peplinskijohn/WLED_KBIS_26/docs/images/1000009515.jpg

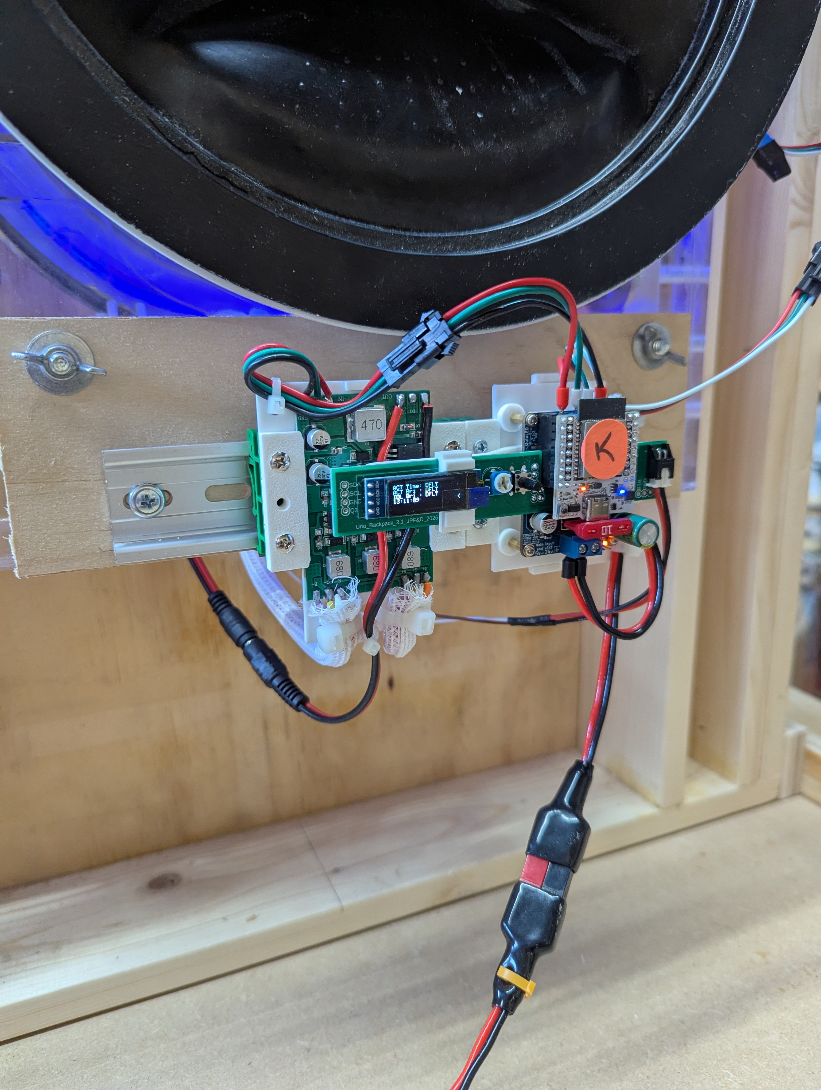
docs/images/1000009515.jpg
