peplinskijohn/WLED_KBIS_26/usermods/KBIS26/assets/Dig_Uno_Image.png

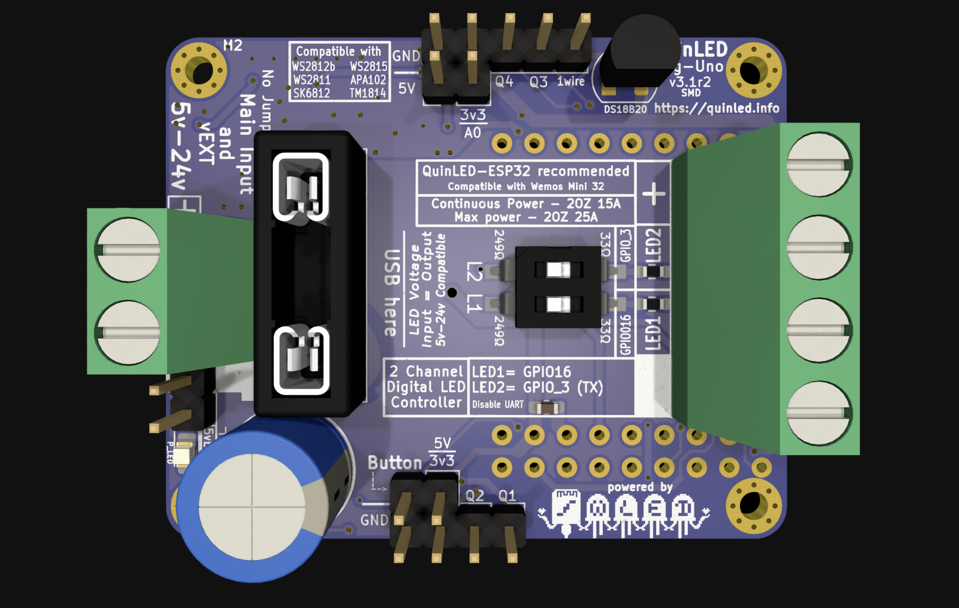
usermods/KBIS26/assets/Dig_Uno_Image.png
