peplinskijohn/WLED_KBIS_26/docs/images/README.md

images taken to document working hardware and assembly.
