peplinskijohn/WLED_KBIS_26/docs/images/1000009498.jpg

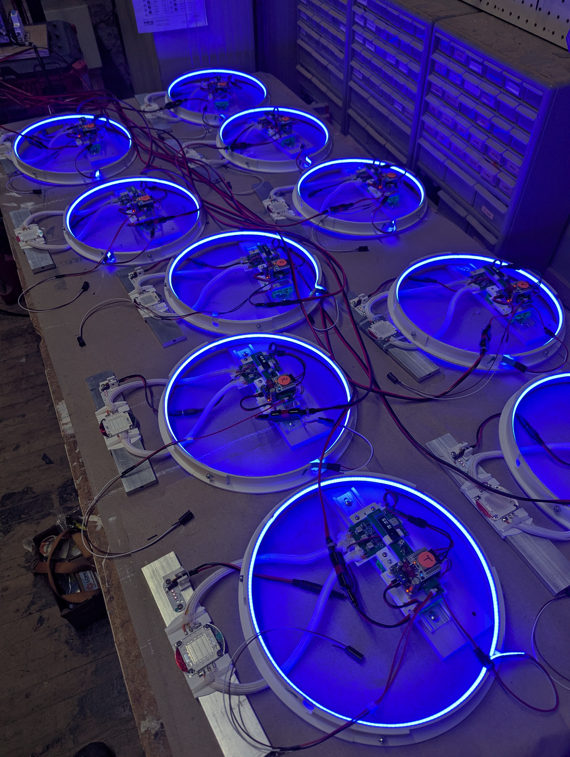
docs/images/1000009498.jpg
