peplinskijohn/WLED_KBIS_26/docs/images/1000009508.jpg

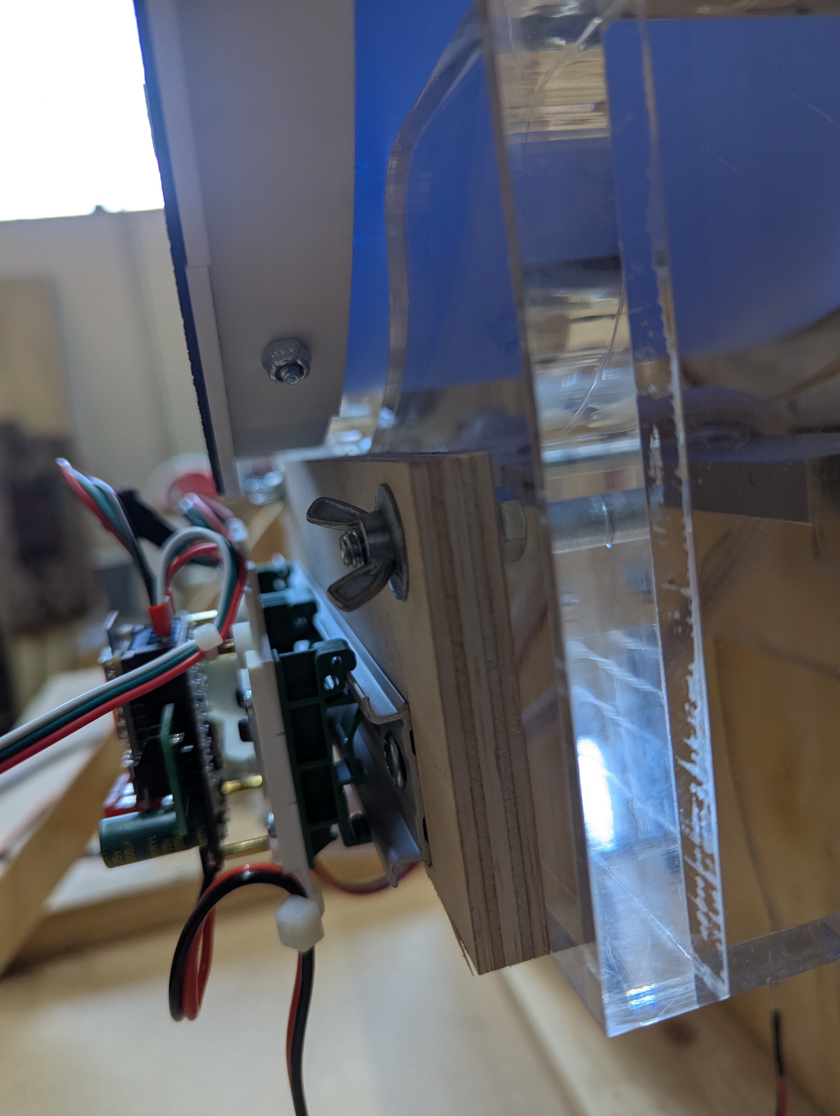
docs/images/1000009508.jpg
