peplinskijohn/WLED_KBIS_26/docs/images/1000009510.jpg

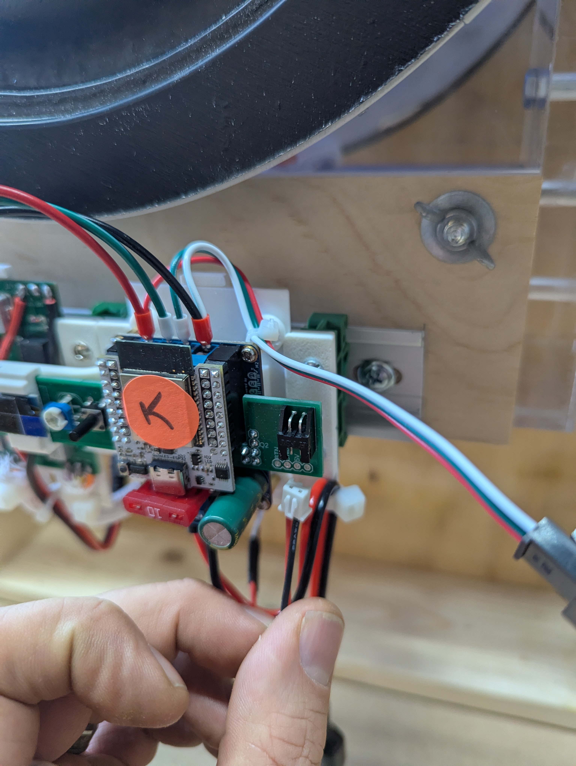
docs/images/1000009510.jpg
