peplinskijohn/WLED_KBIS_26/docs/images/1000009511.jpg

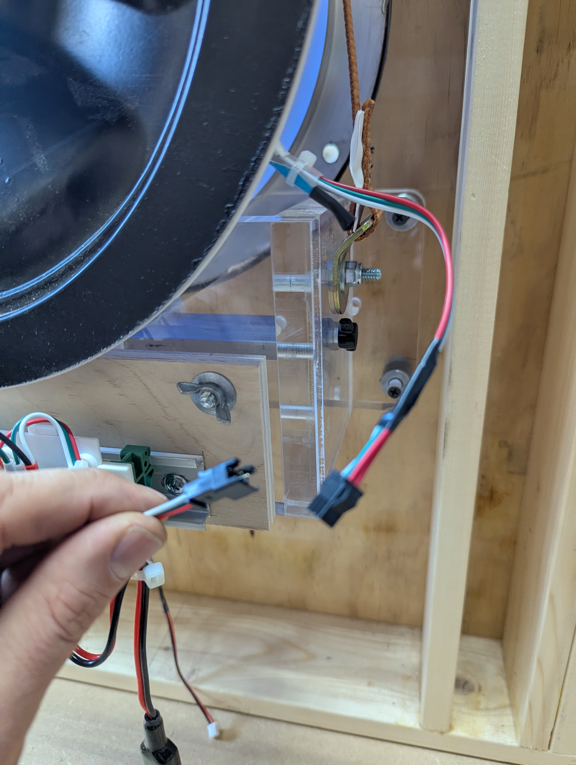
docs/images/1000009511.jpg
