peplinskijohn/WLED_KBIS_26/docs/images/1000009512.jpg

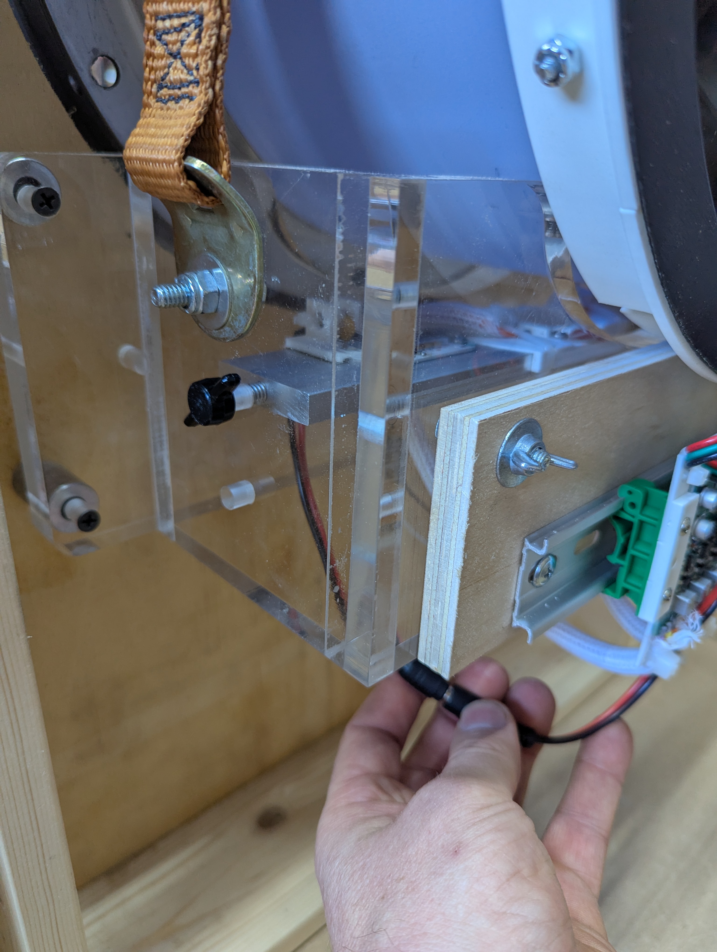
docs/images/1000009512.jpg
