peplinskijohn/WLED_KBIS_26/docs/images/1000009516.jpg

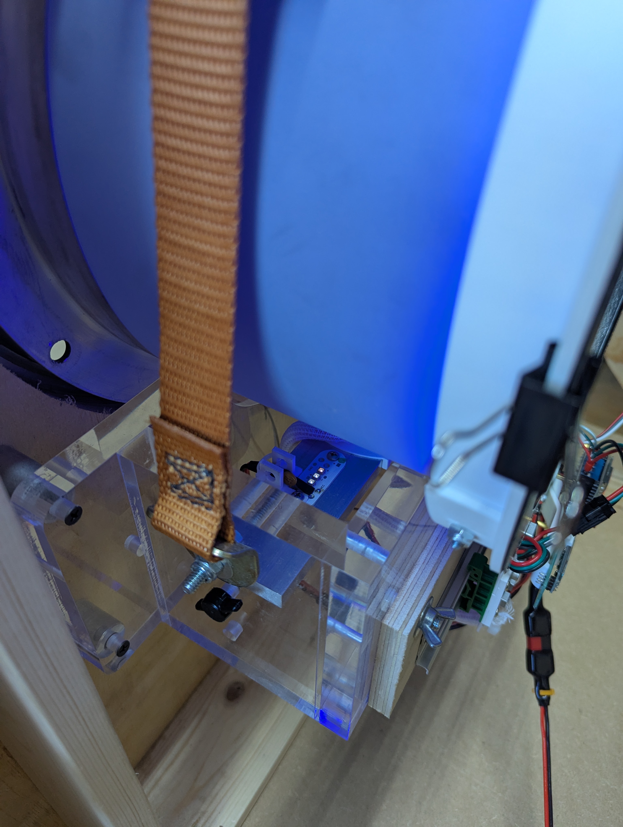
docs/images/1000009516.jpg
