peplinskijohn/WLED_KBIS_26/usermods/KBIS26/assets/BackpackSchmatic.png

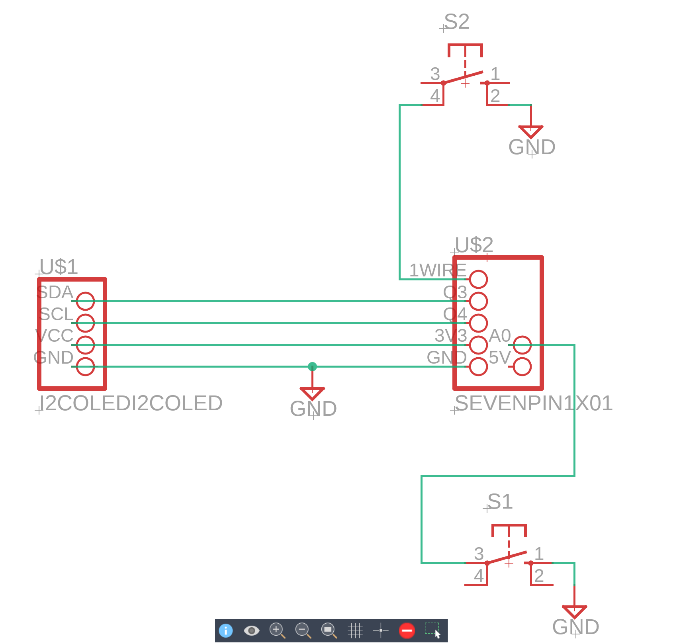
usermods/KBIS26/assets/BackpackSchmatic.png
