peplinskijohn/WLED_KBIS_26/usermods/KBIS26/assets/Dig_ESP_2.png

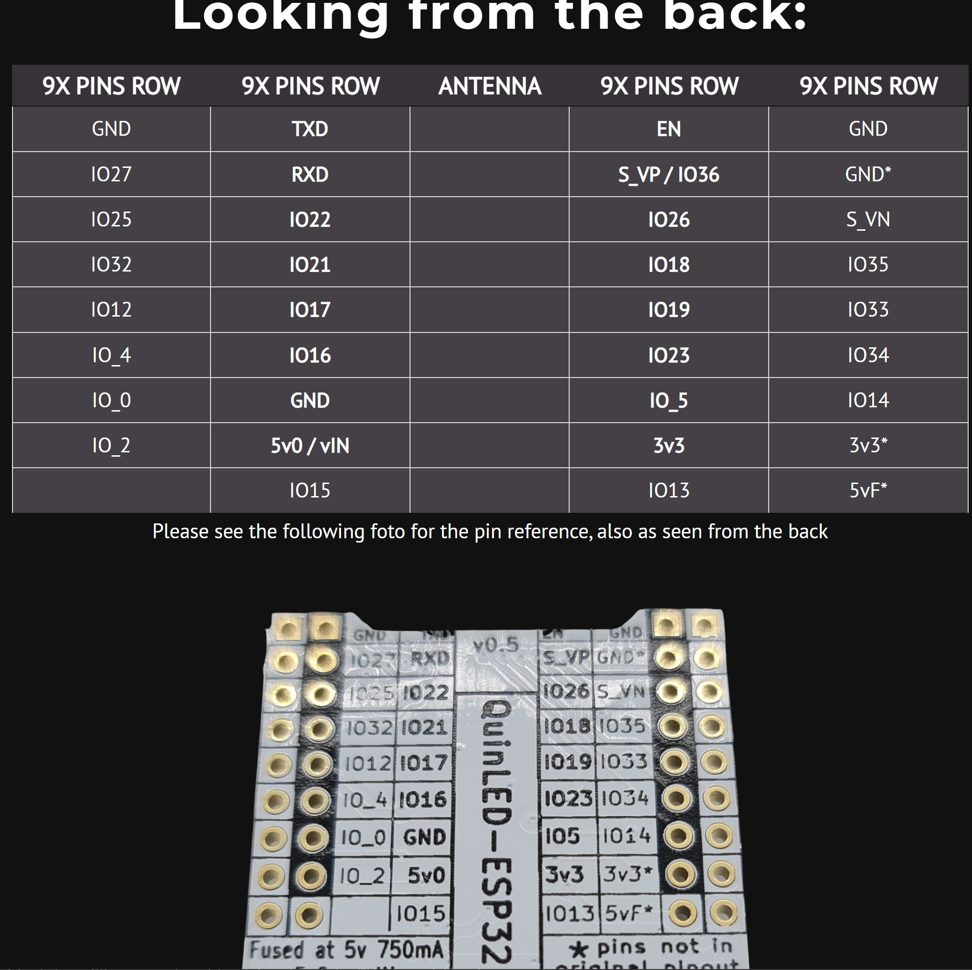
usermods/KBIS26/assets/Dig_ESP_2.png
