peplinskijohn/WLED_KBIS_26/docs/HardwareBOM.md

High Power Led: WS2811 RGB high Power Module DC12-24V 30W RGB Addressable Pixel LED floodlight IP20 (2PCS-WS2811-30W-RGB)
https://www.amazon.com/dp/B0CYXVDVMT?ref=ppx_yo2ov_dt_b_fed_asin_title&th=1

Led Strip:  BTF-LIGHTING FCOB WS2811 IC RGB COB LED Strip DC24V 720LED/m 3.2FT
https://www.amazon.com/dp/B0BTHRV1R6?ref=ppx_yo2ov_dt_b_fed_asin_title&th=1

UVC leds: UV-C Disinfection LED Light Bar Strip
https://tinkersphere.com/standard-leds/3596-uv-c-disinfection-3-led-light-bar-strip.html
150 ohm Resistor 1W

Hardware for Electronics Mounting: 10 Sets C45 PCB DIN Rail Mounting Adapter 35mm 15mm Circuit Board Mounting Bracket Holder Carrier Clip
https://www.amazon.com/dp/B09KZHY8G4?ref=ppx_yo2ov_dt_b_fed_asin_title

400Pcs M2 Motherboard Standoffs&Screws&Nuts Kit
https://www.amazon.com/dp/B0BP6MT7RP?ref=ppx_yo2ov_dt_b_fed_asin_title&th=1

PSU: SDR-480P-24
https://www.mouser.com/ProductDetail/MEAN-WELL/SDR-480P-24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

PCB Parts: 5 Pcs 0.91 Inch I2C OLED Display Module IIC OLED Screen DC 3.3V~5V
https://www.amazon.com/dp/B09MZ8DW4R?ref=ppx_yo2ov_dt_b_fed_asin_title&th=1

228PCS 10 Values 6x6mm & 7x7mm Tactile Push Button Switch
https://www.amazon.com/dp/B0FNJVKZDQ?ref=ppx_yo2ov_dt_b_fed_asin_title&th=1

100 Ohm- 2M Ohm Variable Resistor
https://www.amazon.com/dp/B07WHJMVR4?ref=ppx_yo2ov_dt_b_fed_asin_title

S2B-XH-A-BK(LF)(SN)
https://www.mouser.com/ProductDetail/JST-Commercial/S2B-XH-A-BKLFSN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

Magnetic Reed Switch RC-33 NC/NO Recessed
https://www.amazon.com/Magnetic-RC-33-NC-NO-Recessed/dp/B0BG2V1S73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

XH 2.54mm Connector Kit
https://www.amazon.com/dp/B08G18PWQ6?ref=ppx_yo2ov_dt_b_fed_asin_title&th=1
