peplinskijohn/WLED_KBIS_26/docs/3d_print_files/KBIS26_Ring_1.3mf

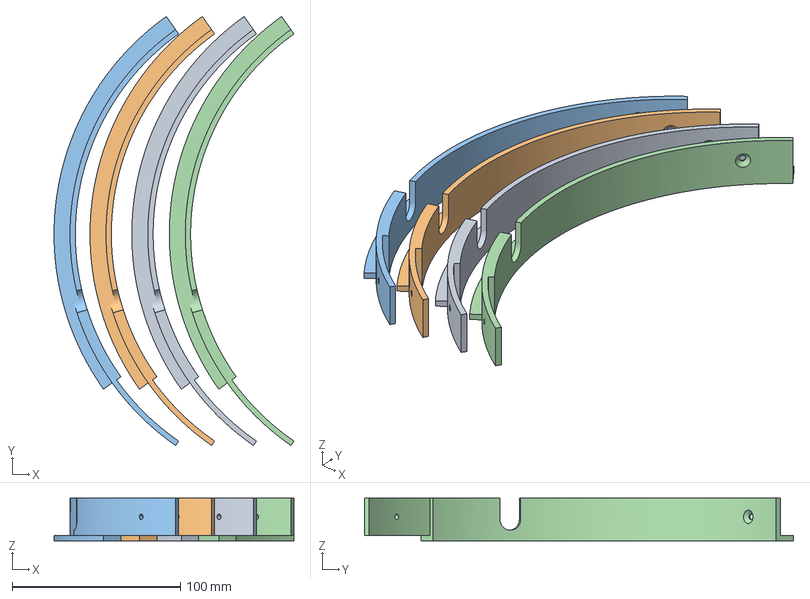
[picture p12: CAD file, 2026-02-28]
docs/3d_print_files/KBIS26_Ring_1.3mf
142.6 x 254.8 x 25.4 mm
KBIS26_Configuration 1_Body1.stl x 4
