peplinskijohn/WLED_KBIS_26/docs/3d_print_files/UVC_Clips_1.3mf

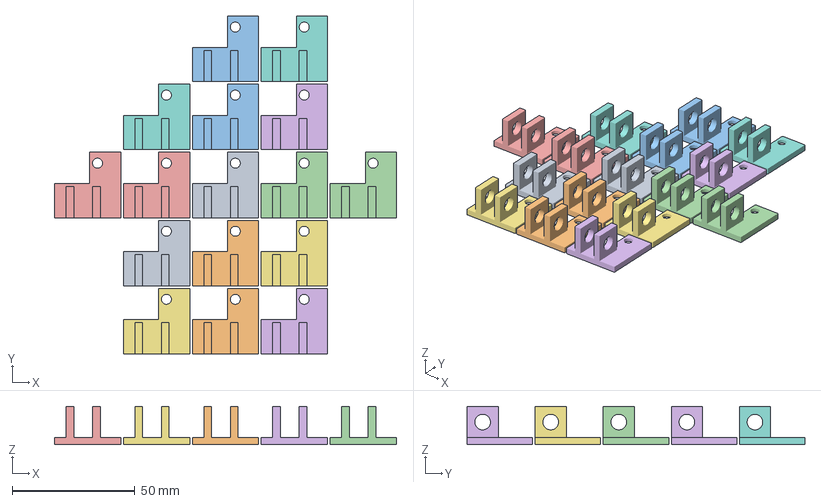
[picture p13: CAD file, 2026-02-28]
docs/3d_print_files/UVC_Clips_1.3mf
139.1 x 137.5 x 15.5 mm
KBIS26_Configuration 1_Body2.stl x 16
