peplinskijohn/WLED_KBIS_26/docs/3d_print_files/Pinch_1.3mf

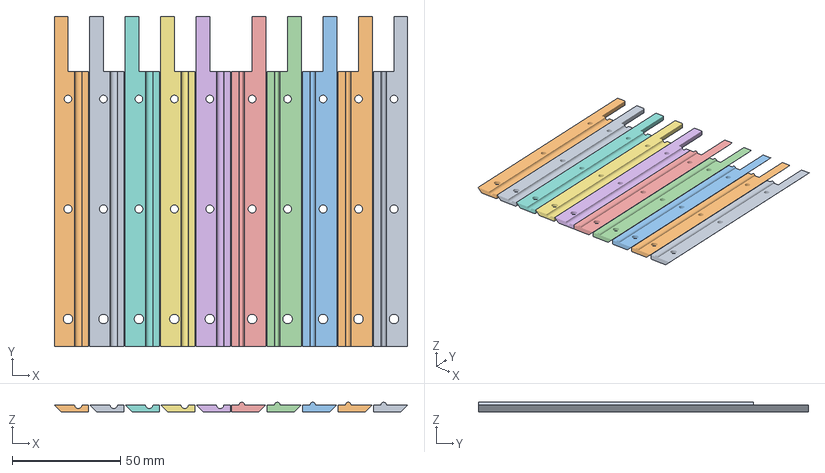
[picture p14: CAD file, 2026-02-28]
docs/3d_print_files/Pinch_1.3mf
163.2 x 152.4 x 4.44 mm
KBIS26_Configuration 1_Pinch.stl_1 x 5
KBIS26_Configuration 1_Pinch.stl_2 x 5
