peplinskijohn/WLED_KBIS_26/docs/3d_print_files/30W_Mount_1.3mf

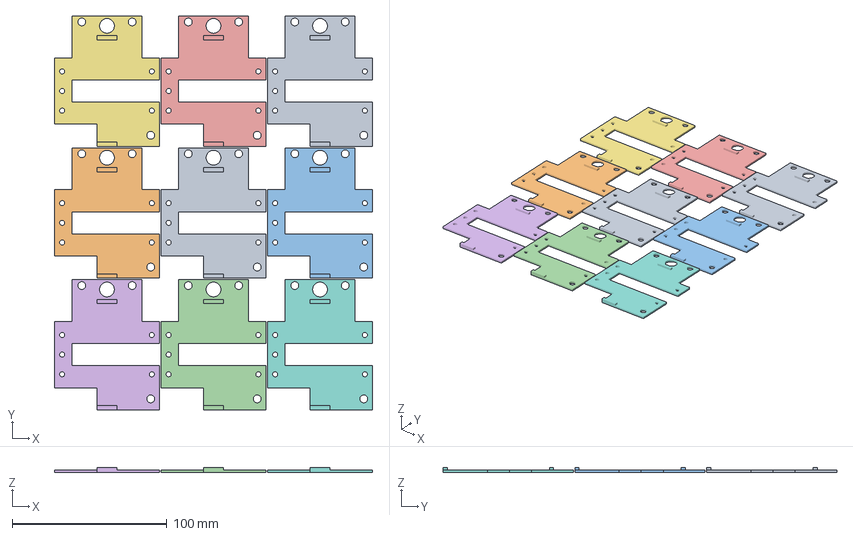
[picture p15: CAD file, 2026-02-28]
docs/3d_print_files/30W_Mount_1.3mf
205.6 x 254.6 x 3.18 mm
KBIS26_Configuration 1_Body1.stl x 9
