peplinskijohn/WLED_KBIS_26/docs/3d_print_files/Houses_1.3mf

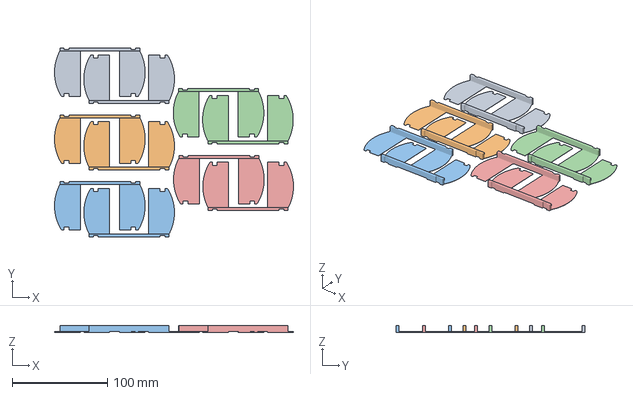
[picture p16: CAD file, 2026-02-28]
docs/3d_print_files/Houses_1.3mf
250.5 x 197.8 x 7.35 mm
Assembly x 5
