peplinskijohn/WLED_KBIS_26/docs/3d_print_files/KBIS26_Mounts_1.3mf

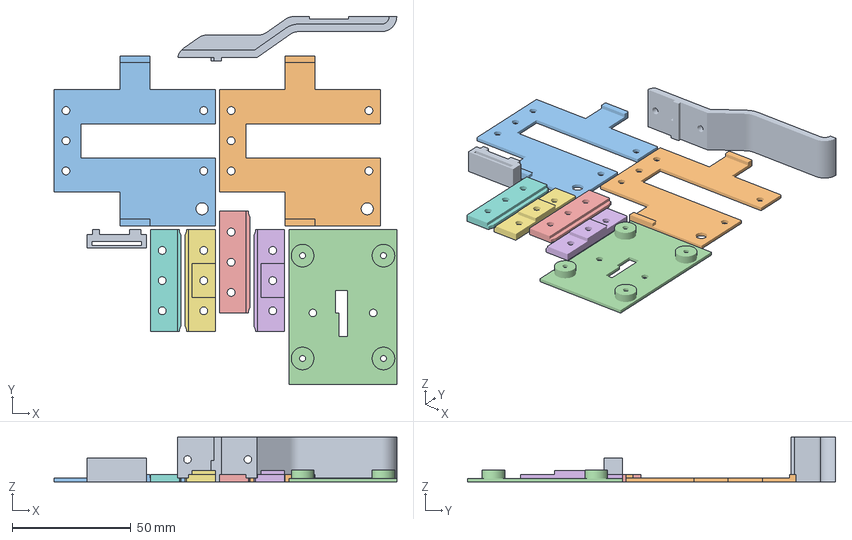
[picture p17: CAD file, 2026-02-28]
docs/3d_print_files/KBIS26_Mounts_1.3mf
144.1 x 154.8 x 18.9 mm
KBIS26_Configuration 1_Electronics.stl_8
KBIS26_Configuration 1_Electronics.stl_2 x 2
KBIS26_Configuration 1_Electronics.stl_5
KBIS26_Configuration 1_Electronics.stl_3 x 2
KBIS26_Configuration 1_Electronics.stl_4 x 2
KBIS26_Configuration 1_Electronics.stl_7
