peplinskijohn/WLED_KBIS_26/docs/3d_print_files/README.md

stls of pla parts used to hold electrical components.
Mounts for Dig Uno use brass standoffs: m2 x 10mm
