peplinskijohn/WLED_KBIS_26/usermods/KBIS26/assets/Dig-Uno_PinOut_Guide.png

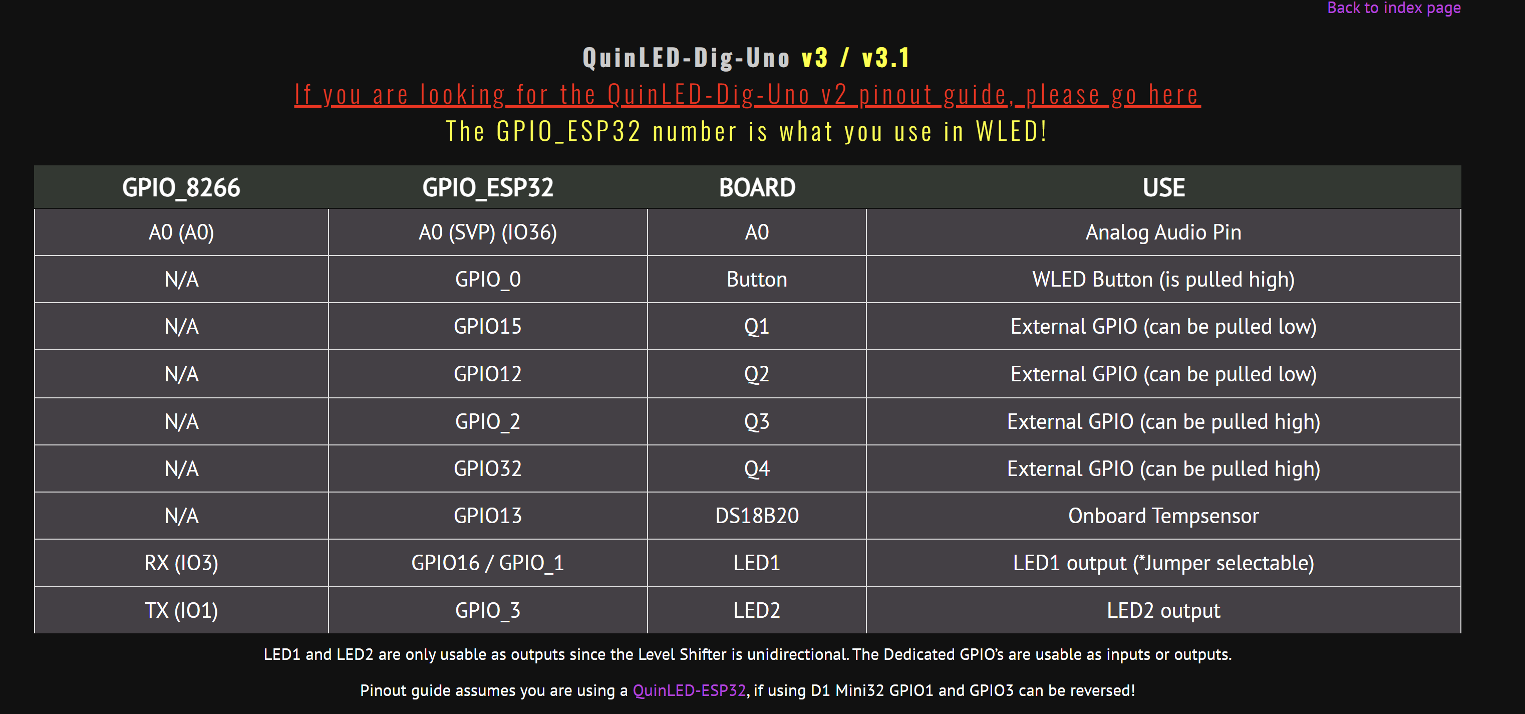
usermods/KBIS26/assets/Dig-Uno_PinOut_Guide.png
