peplinskijohn/WLED_KBIS_26/docs/3d_print_files/Electronics_Panel_1.pdf

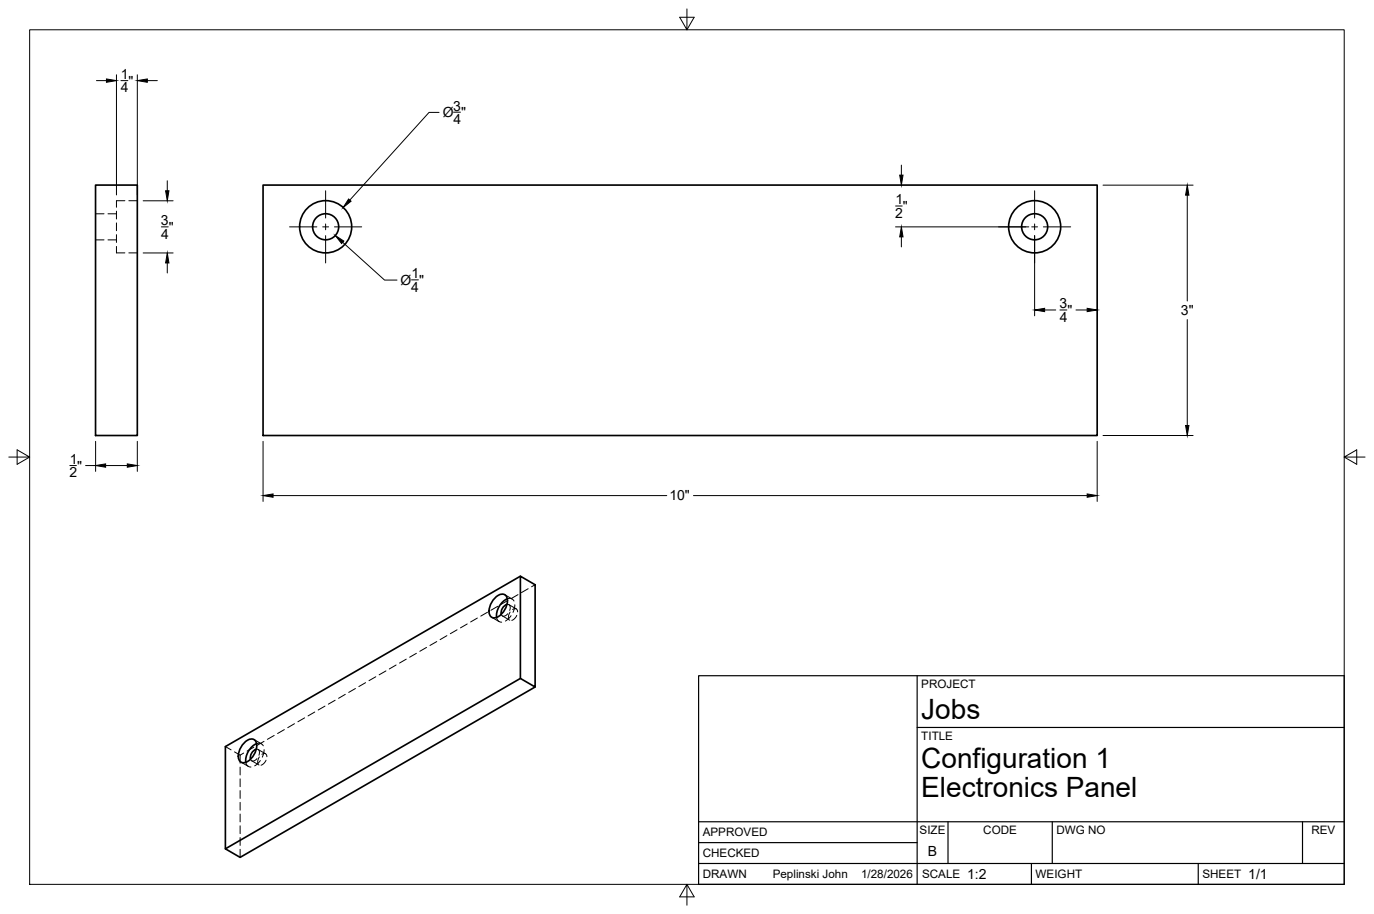
[picture p19: page 1]
SIZE; CODE; DWG NO; REV; Peplinski John; Electronics Panel; Configuration 1
