peplinskijohn/WLED_KBIS_26/(commit log)

2026-01-16 updated assets
    [ESP32 Pins (copy 2).xlsx]
2026-01-21 usermod is working
    [ESP32 Pins (copy 2).xlsx]
2026-02-28 Create README.md
    gerber
2026-02-28 Add files via upload
    files
    [copper_bottom.gbr, copper_top.gbr, drill_1_64.xln, gerber_job.gbrjob, profile.gbr, silkscreen_bottom.gbr, silkscreen_top.gbr, soldermask_bottom.gbr]
2026-02-28 added subfolders
    added subfolders
    [30W_Mount_1.3mf, Houses_1.3mf, KBIS26_Mounts_1.3mf, KBIS26_Ring_1.3mf, Pinch_1.3mf, UVC_Clips_1.3mf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]
